fixxl/fuocostep/README.md

Dieses Repository beinhaltet die nötigen Dateien für den Selbstbau-Stepper FUOCO STEP.

ANLEITUNG: Handbuch zu Aufbau und Betrieb des Steppers

BOOTLOADER: Bootloader für den Mikrocontroller, um Firmware via USB aufspielen zu können

FIRMWARE-QUELLCODE: Firmware des Mikrocontrollers

FIRMWARE-UPDATER: Graphische Oberfläche zum Einspielen der Firmware

GUI: Graphische Oberfläche zur Programmierung des Steppers
