fixxl/fuocostep/3D-Druck/Abdeckung_Stiftleiste.stl

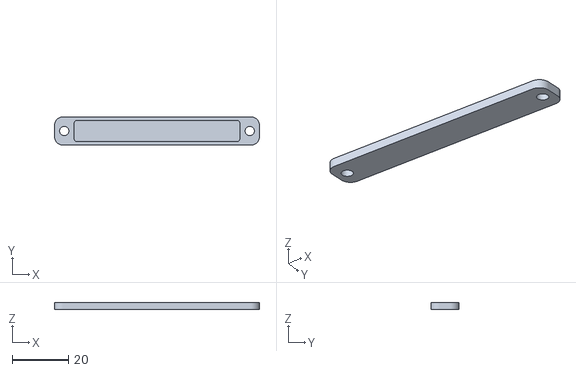
[picture p1: CAD file, 2020-04-19]
3D-Druck/Abdeckung_Stiftleiste.stl
73.0 x 10.0 x 2.50
