fixxl/fuocostep/Anleitung/Bilder/gui.png

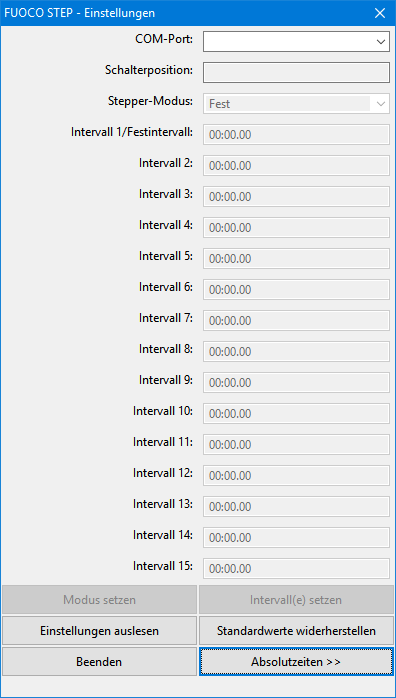
Anleitung/Bilder/gui.png
