fixxl/fuocostep/Anleitung/oberflaeche.jpg

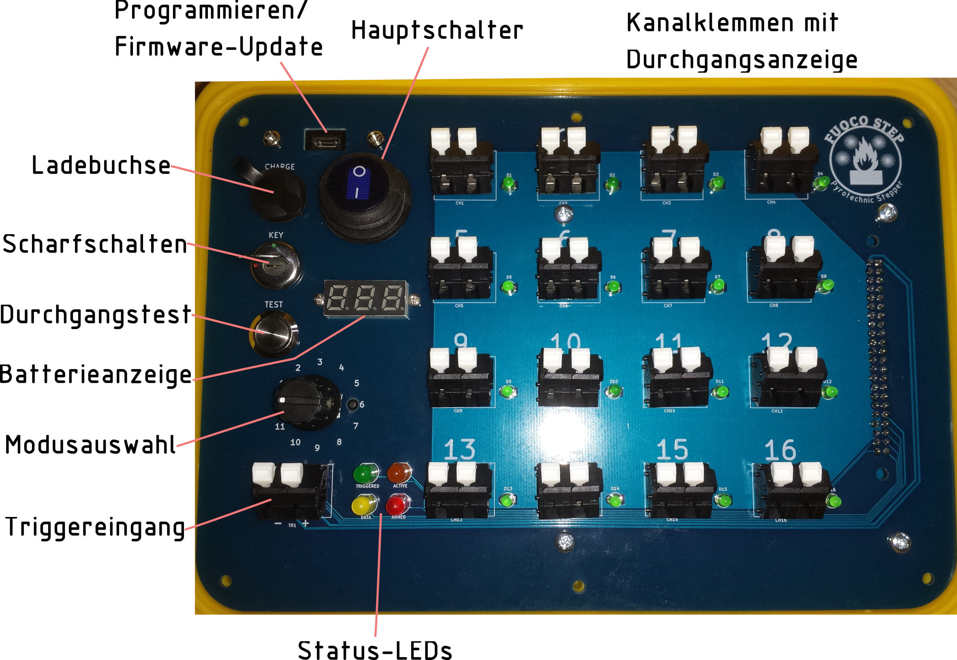
Anleitung/oberflaeche.jpg
