fixxl/fuocostep/Schematics/fuocostep-basis-Assembly.pdf

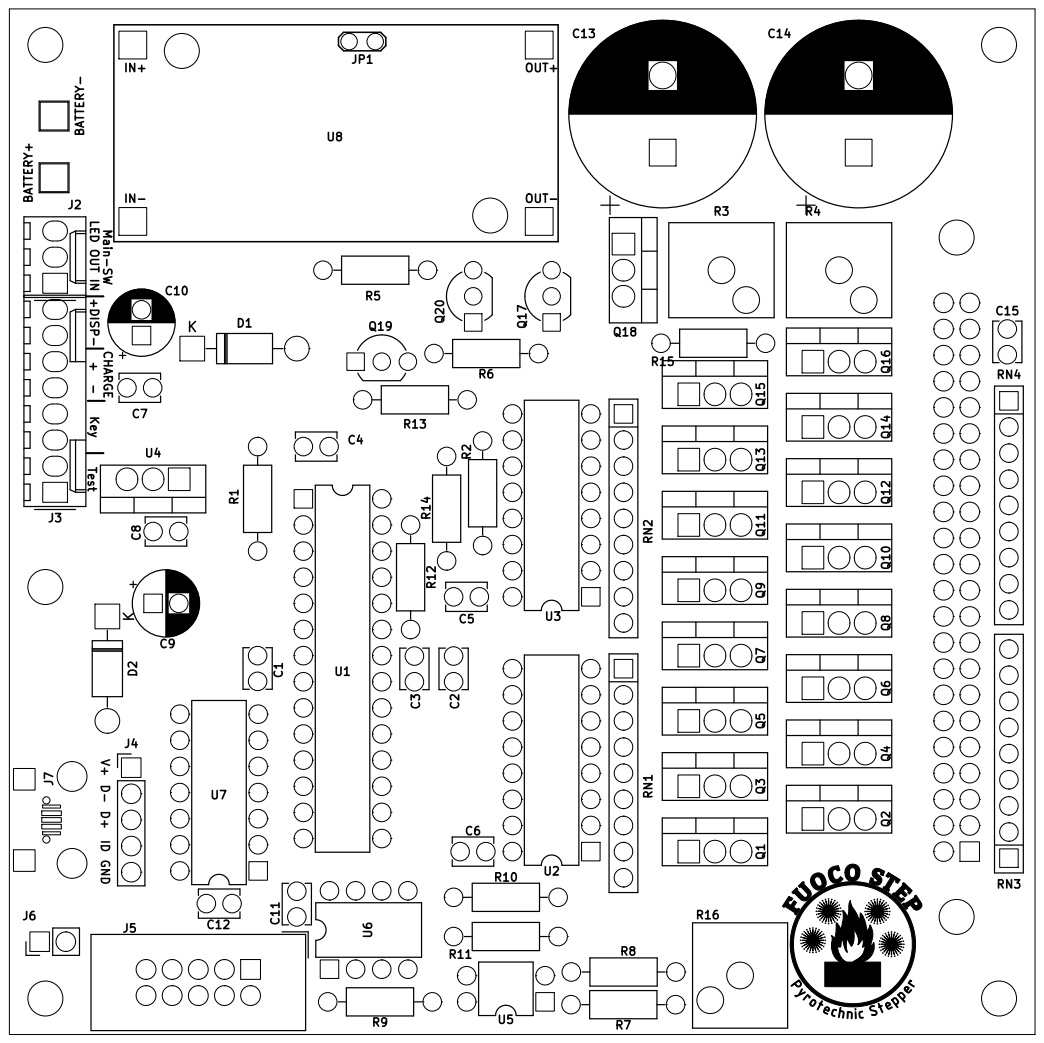
[picture p22: page 1]

GND ID D+ D- V+ LED OUT IN +DISP- CHARGE + - Main-SW Key Test J7 R16 Q18 Q6 Q1 Q2 Q3 Q4 Q5 Q7 Q8 Q9 Q10 Q11 Q12 Q13 Q14 Q15 Q16
