fixxl/fuocostep/Schematics/Fuocostep-Panel-Assembly.pdf

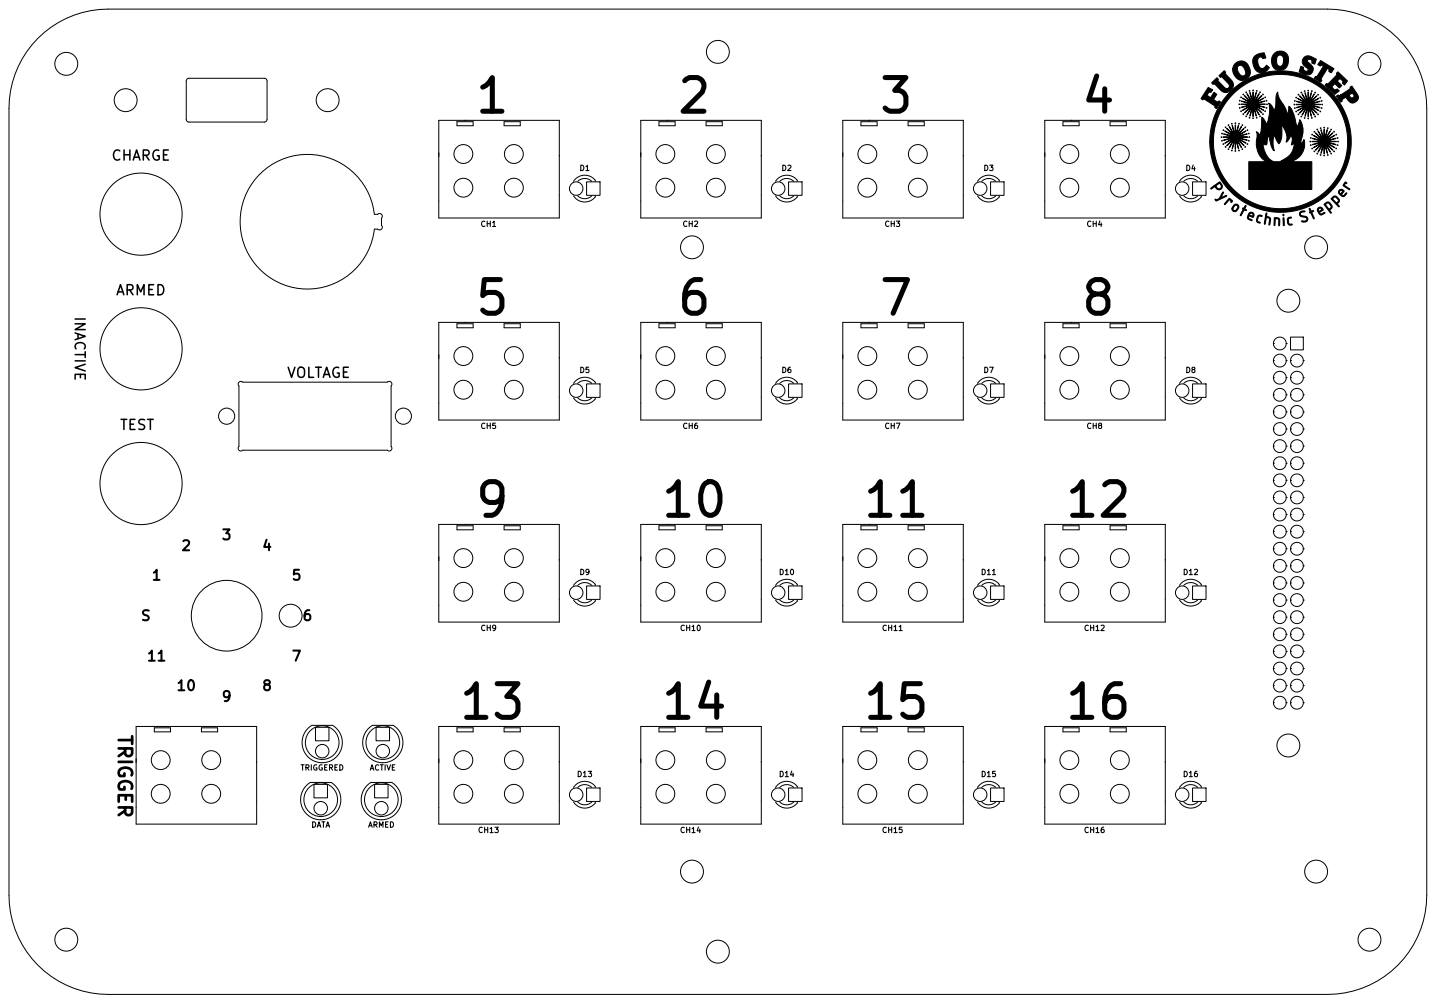
[picture p26: page 1]
