fixxl/fuocostep/Schematics/Fuocostep-Panel-Schematic.pdf

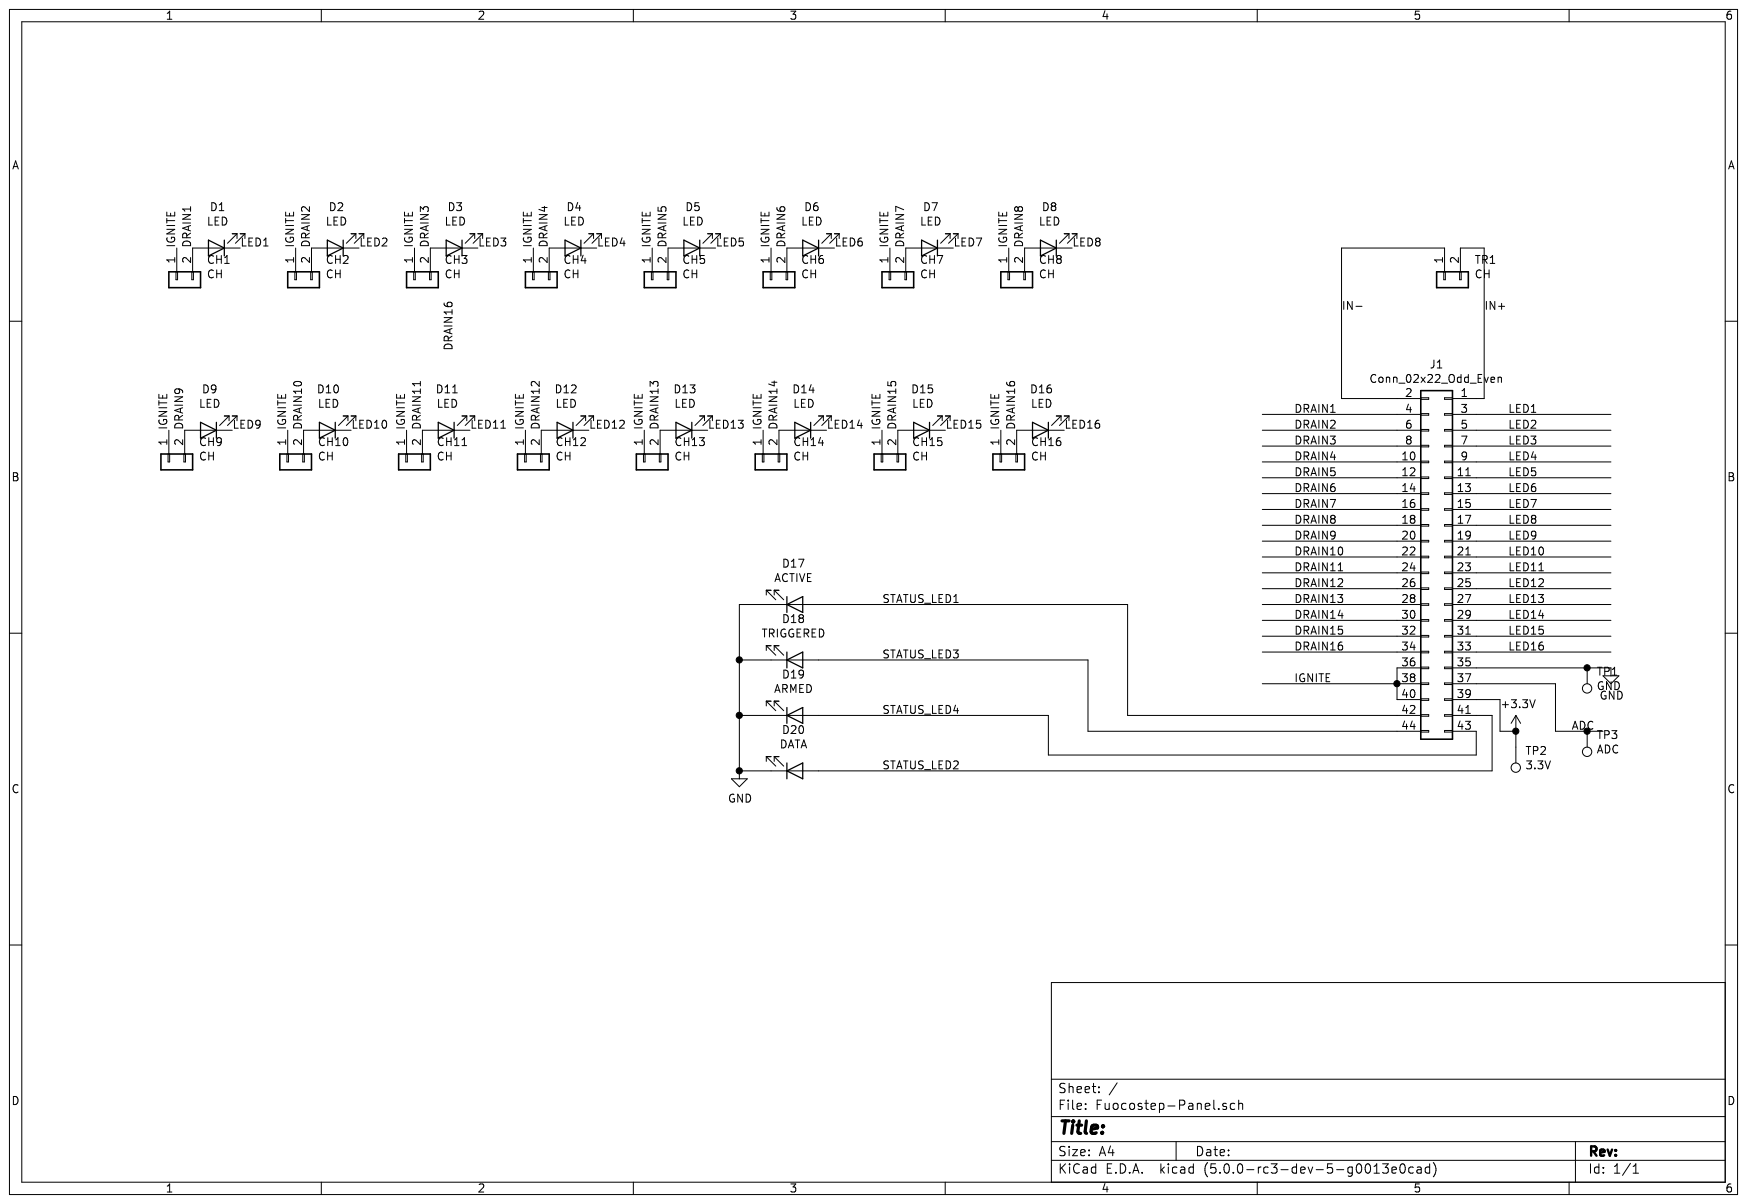
[picture p27: page 1]
