fixxl/fuocostep/Anleitung/Bilder/Logo.pdf

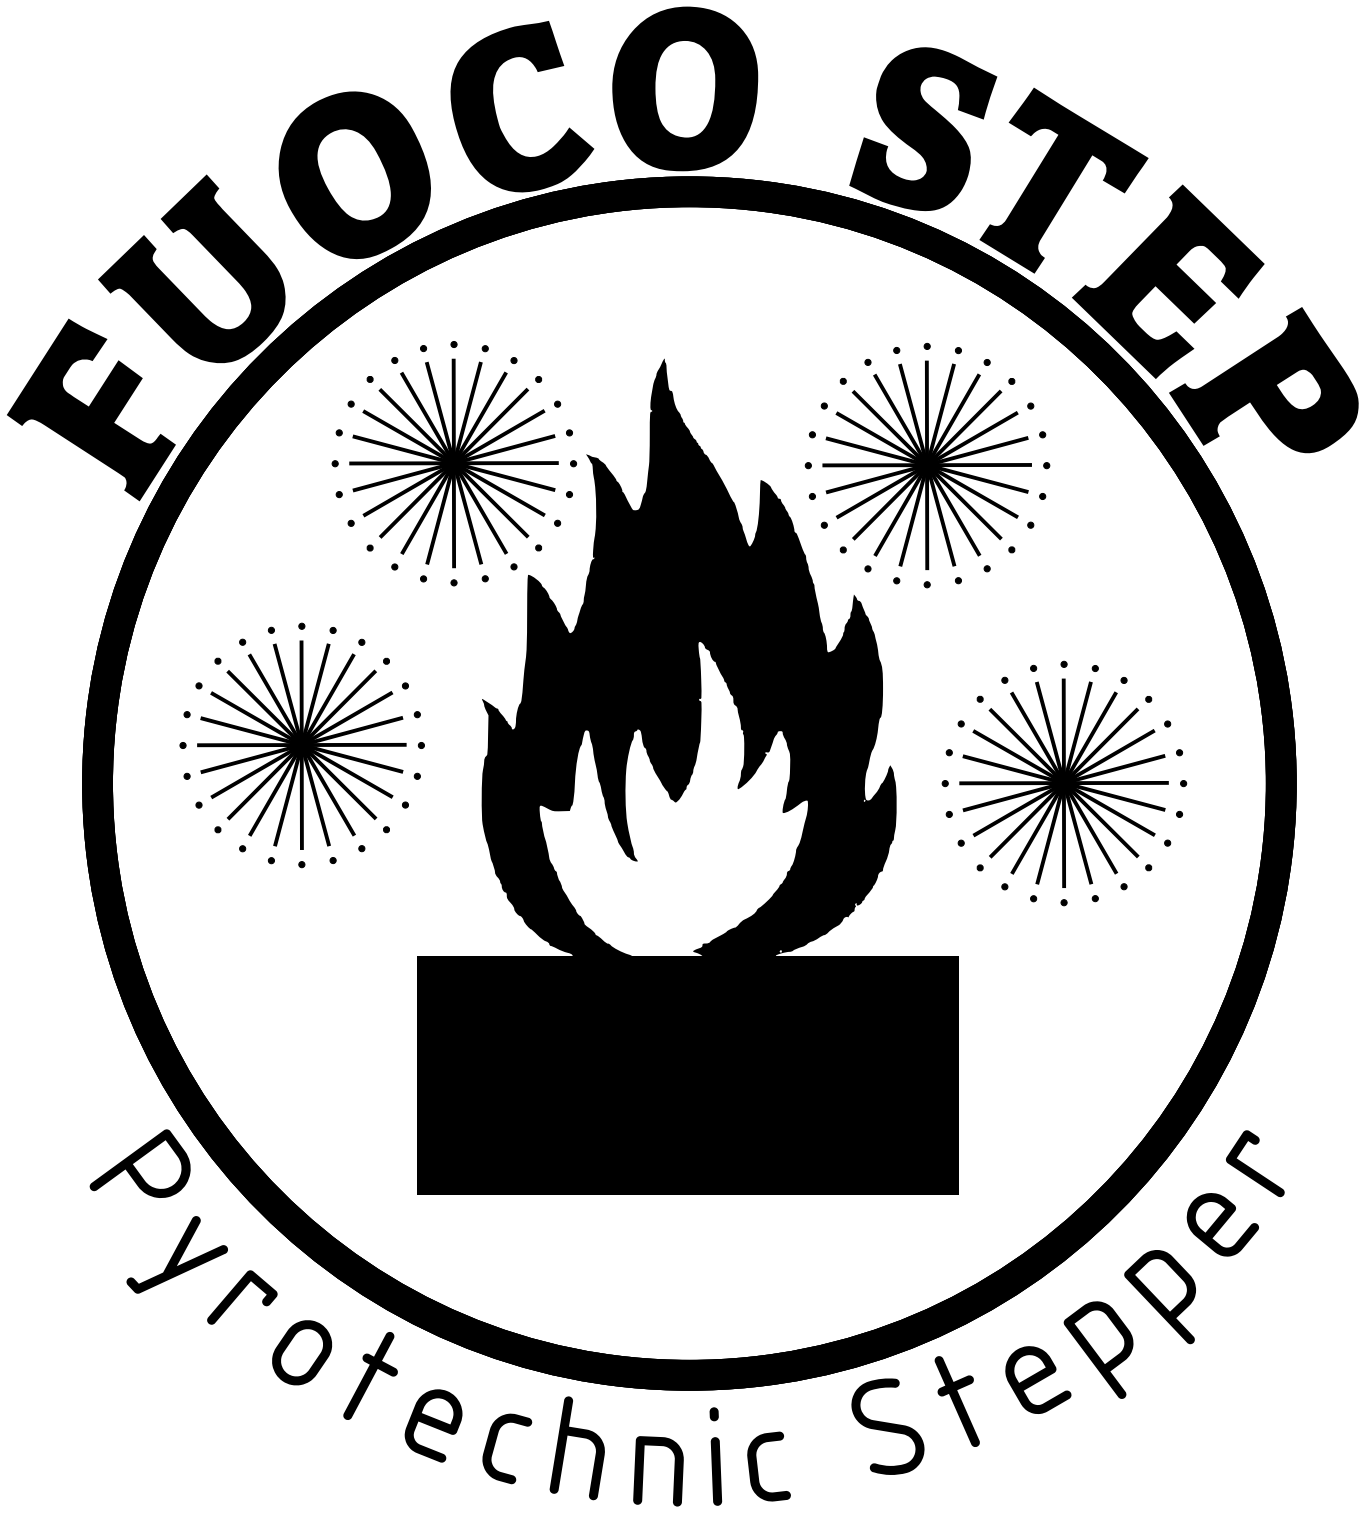
[picture p28: page 1]
