fixxl/fuocostep/Firmware-Updater/UpdateLoader.ini

[UpdateLoader]
ComPort=1
BootloaderPassword=Peda
FirmwareFilename=..\Firmware-Quellcode\Release\Fuocostep.hex
Page=0

[Advanced]
BaudRate=9600
FirmwareKeyParseMode=1
ShowMemory=0
HideMessages=1
Enabled=1
ProgramWrite=1
ProgramVerify=1
ProgramStart=1
ReloadFile=1
DetectOneWire=0
ToggleDTR=0
InvertCom=0
EnableFirmwareKey=1
FirmwareKeyOnce=1
FirmwareKey=0A 6B 69 6C 6C 0A
ConnectTries=100

[PaketMode]
Enabled=1
MiniGUI=0
ModalGUI=0
HideAdvancedMode=1
LockFilename=1
LockPassword=1
HidePassword=1
