fixxl/fuocostep/Firmware-Quellcode/timeparser.h

/*
 * timeparser.h
 *
 *  Created on: 08.04.2018
 *      Author: Felix
 */

#ifndef TIMEPARSER_H_
#define TIMEPARSER_H_

#define RETURNERROR 0xFFFF

uint16_t timecalc( char *timestring );
uint8_t timedisplay( uint16_t timerval, char *output_string );

#endif /* TIMEPARSER_H_ */
