fixxl/fuocostep/(commit log)

2018-06-07 Code documentation, bugfixing GUI now also running on Linux
    [stepper.c, stepper.h, stepsetter.py, terminal.c]
2018-06-12 GUI Python3-compliant Adapted resistor value for R5
2018-06-12 Removed drivers as they lose signature Adapted manual and GUI
2018-06-13 GUI improvement for fixed intervals
    [stepsetter.py]
2018-06-14 Added photo of resistors
2018-06-19 Display problem for fixed trigger interval solved Manual refinements
    [stepsetter.py, terminal.c]
2018-07-11 Schematics and assembly drawings
2018-07-15 Bugfix: Channel reset after hardware trigger does not occur anymore
    [stepper.c, stepper.h]
2018-07-16 More logical interrupt handling according to port numbers
2018-07-17 Boosted interrupt routine performance
2018-07-18 Pin logic corrected (part is commented anyway, thus no change)
    [stepper.c]
2018-10-14 Removed console prints from GUI
2019-01-03 Added Gerber files
2019-01-10 Gerber update
2020-04-19 Small fixes, 3D-print model
    [Abdeckung_Stiftleiste.stl]
2020-05-22 Bugfix: Saving settings received by quickwrite
    [adc.c, eeprom.c, global.h, shiftregister.c, shiftregister.h, stepper.c]
